bartoszp1992/pulsar/simulation/StepUpDown.asc

C1: cap; 100µ; Rser=10m
C2: cap; 100µ; Rser=100m
C3: cap; 10µ; Rser=10m
D1: diode
D2: diode
L1: ind; 33µ; Rser=36m
M1: pmos; FDS4559_P
M2: nmos; IRFZ44N
R1: res; 1k
R2: res; 1k
R3: res; 1
V1: voltage; 5
V2: voltage; PULSE(0 10 0 0 0 1900ns 2000ns)
V3: voltage; PULSE(0 10 0 0 0 1500ns 2000ns)
Named nets: INPUT, HSW, 0, LSW, OUTPUT
.tran 0 5m 0 10m startup
