bartoszp1992/pulsar/simulation/SEPIC.asc

C1: cap; 10µ
C2: cap; 100µ
D1: diode
L1: ind; 33µ
L2: ind; 33µ
M1: nmos; IRFZ44BART
R1: res; 50
V1: voltage; PULSE(0 5 0 0 0 15us 20us)
V2: voltage; 10
Named nets: 0, IN, OUT, GATE
.tran 0 1ms 0 10ms
.model IRFZ44BART VDMOS(Rg=1.94 Vto=4 Rd=5.0m Rs=0.0m Rb=6.8m Kp=19 Cgdmax=2.0n Cgdmin=0.08n Cgs=1.4n Cjo=0.9n Is=1.5p tt=63n ksubthres=.1 mfg=International_Rectifier Vds=55 Ron=13.9m Qg=63n)
