bartoszp1992/pulsar/pulsarPCB/pulsarPCB.kicad_pcb

## KiCad design pulsarPCB/pulsarPCB.kicad_pcb (2024-03-15)

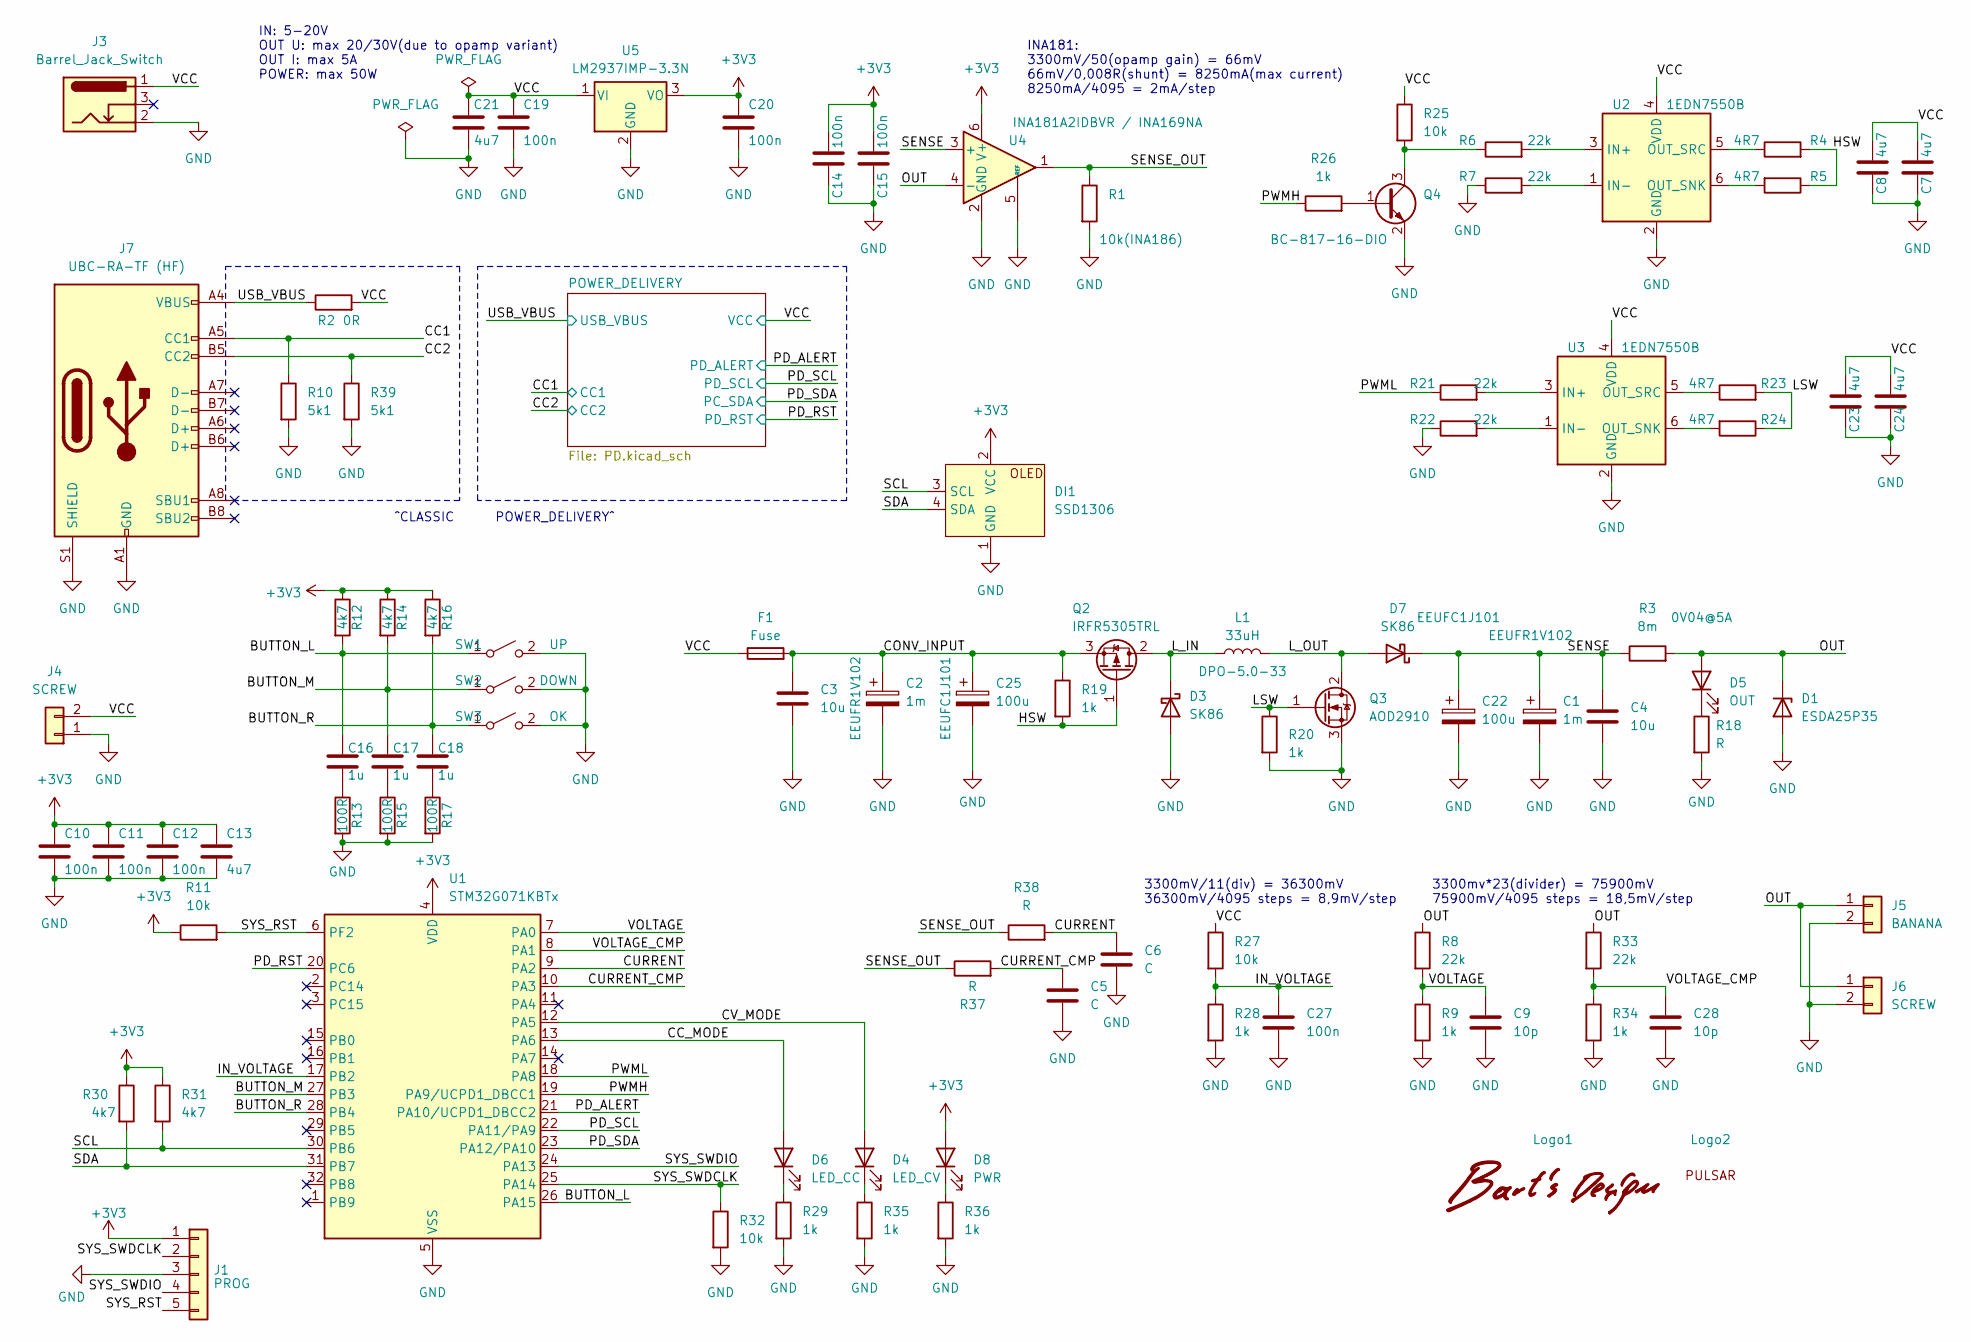
[picture p1: schematic pulsarPCB.kicad_sch]

Parts:
C1, C2: 1m; CP_Radial_D12.5mm_P5.00mm
C3, C4: 10u; C_1206_3216Metric
C5, C6: C; C_0603_1608Metric
C7, C8, C13, C21, C23, C24: 4u7; C_1206_3216Metric
C9, C28: 10p; C_0603_1608Metric
C10, C11, C12, C14, C15, C19, C20, C27: 100n; C_0603_1608Metric
C16, C17, C18: 1u; C_0603_1608Metric
C22, C25: 100u; CP_Radial_D10.0mm_P5.00mm
D1: ESDA25P35; D_0603_1608Metric
D3, D7: SK86; D_SMC
D4: LED_CV; LED_0603_1608Metric
D5: OUT; LED_0603_1608Metric
D6: LED_CC; LED_0603_1608Metric
D8: PWR; LED_0603_1608Metric
DI1: SSD1306
F1: Fuse; Fuse_1206_3216Metric
J1: PROG; PinHeader_1x05_P2.54mm_Vertical
J3: Barrel_Jack_Switch; BarrelJack_Horizontal
J4, J6: SCREW; DEGSON DG301-5.0-2.0P
J5: BANANA; BANANA 4mm
J7: UBC-RA-TF (HF)
L1: 33uH; DPO-5.0-33
Logo1: Bart's Design
Logo2: PULSAR
Q2: IRFR5305TRL; TO-252-2
Q3: AOD2910; TO-252-2
Q4: BC-817-16-DIO; SOT-23
R1: 10k(INA186); R_0603_1608Metric
R2: 0R; D_0603_1608Metric
R3: 8m; R_2512_6332Metric
R4, R5, R23, R24: 4R7; R_1206_3216Metric
R6, R7, R8, R21, R22, R33: 22k; R_0603_1608Metric
R9, R19, R20, R26, R28, R29, R34, R35, R36: 1k; R_0603_1608Metric
R10, R39: 5k1; R_0603_1608Metric
R11, R25, R27, R32: 10k; R_0603_1608Metric
R12, R14, R16, R30, R31: 4k7; R_0603_1608Metric
R13, R15, R17: 100R; R_0805_2012Metric
R18, R37, R38: R; R_0603_1608Metric
SW1: UP; SW_PUSH_6mm
SW2: DOWN; SW_PUSH_6mm
SW3: OK; SW_PUSH_6mm
U1: STM32G071KBTx; LQFP-32_7x7mm_P0.8mm
U2, U3: 1EDN7550B; SOT-23-6
U4: INA181A2IDBVR / INA169NA; SOT-23-6
U5: LM2937IMP-3.3N; SOT-223-3_TabPin2

Connections:
+3V3: C10.1, C11.1, C12.1, C13.1, C14.2, C15.2, C20.1, D8.2 (A), DI1.2 (VCC), J1.1, R11.1, R12.1, R14.1, R16.1, R30.1, R31.1, U1.4 (VDD), U4.6 (V+), U5.3 (VO); also elsewhere on the board
/BUTTON_L: C16.1, R12.2, SW1.1 (A), U1.26 (PA15)
/BUTTON_M: C17.1, R14.2, SW2.1 (A), U1.27 (PB3)
/BUTTON_R: C18.1, R16.2, SW3.1 (A), U1.28 (PB4)
/CC1: J7.A5 (CC1), R10.1; also elsewhere on the board
/CC2: J7.B5 (CC2), R39.1; also elsewhere on the board
/CC_MODE: D6.2 (A), U1.13 (PA6)
/CONV_INPUT: C2.1, C3.1, C25.1, F1.2, Q2.3 (S), R19.1
/CURRENT: C6.2, R38.2, U1.9 (PA2)
/CURRENT_CMP: C5.2, R37.2, U1.10 (PA3)
/CV_MODE: D4.2 (A), U1.12 (PA5)
/HSW: Q2.1 (G), R4.2, R5.1, R19.2
/IN_VOLTAGE: C27.1, R27.2, R28.1, U1.17 (PB2)
/LSW: Q3.1 (G), R20.1, R23.2, R24.1
/L_IN: D3.1 (K), L1.1, Q2.2 (D)
/L_OUT: D7.2 (A), L1.2, Q3.2 (D)
/OUT: D1.1 (K), D5.2 (A), J5.1, J6.1, R3.2, R8.1, R33.1, U4.4 (-)
/PD_ALERT: U1.21 (PA10/UCPD1_DBCC2); also elsewhere on the board
/PD_RST: U1.20 (PC6); also elsewhere on the board
/PD_SCL: U1.22 (PA11/PA9); also elsewhere on the board
/PD_SDA: U1.23 (PA12/PA10); also elsewhere on the board
/PWMH: R26.1, U1.19 (PA9/UCPD1_DBCC1)
/PWML: R21.1, U1.18 (PA8)
/SCL: DI1.3 (SCL), R31.2, U1.30 (PB6)
/SDA: DI1.4 (SDA), R30.2, U1.31 (PB7)
/SENSE: C1.1, C4.1, C22.1, D7.1 (K), R3.1, U4.3 (+)
/SENSE_OUT: R1.1, R37.1, R38.1, U4.1
/SYS_RST: J1.5, R11.2, U1.6 (PF2)
/SYS_SWDCLK: J1.2, R32.1, U1.25 (PA14)
/SYS_SWDIO: J1.4, U1.24 (PA13)
/USB_VBUS: J7.A4 (VBUS), J7.A9 (VBUS), J7.B4 (VBUS), J7.B9 (VBUS), R2.1; also elsewhere on the board
/VCC: C7.2, C8.2, C19.1, C21.2, C23.2, C24.2, F1.1, J3.1, J4.2, R2.2, R25.1, R27.1, U2.4 (VDD), U3.4 (VDD), U5.1 (VI); also elsewhere on the board
/VOLTAGE: C9.1, R8.2, R9.1, U1.7 (PA0)
/VOLTAGE_CMP: C28.1, R33.2, R34.1, U1.8 (PA1)
GND: C1.2, C2.2, C3.2, C4.2, C5.1, C6.1, C7.1, C8.1, C9.2, C10.2, C11.2, C12.2, C13.2, C14.1, C15.1, C19.2, C20.2, C21.1, C22.2, C23.1, C24.1, C25.2, C27.2, C28.2, D1.2 (A), D3.2 (A), DI1.1 (GND), J1.3, J3.2, J4.1, J5.2, J6.2, J7.A1 (GND), J7.A12 (GND), J7.B1 (GND), J7.B12 (GND), J7.S1 (SHIELD), Q3.3 (S), Q4.2 (E), R1.2, R7.1, R9.2, R10.2, R13.2, R15.2, R17.2, R18.2, R20.2, R22.1, R28.2, R29.2, R32.2, R34.2, R35.2, R36.2, R39.2, SW1.2 (B), SW2.2 (B), SW3.2 (B), U1.5 (VSS), U2.2 (GND), U3.2 (GND), U4.2 (GND), U4.5 (REF), U5.2 (GND); also elsewhere on the board
unnamed: C16.2, R13.1
unnamed: C17.2, R15.1
unnamed: C18.2, R17.1
unnamed: D4.1 (K), R35.1
unnamed: D5.1 (K), R18.1
unnamed: D6.1 (K), R29.1
unnamed: D8.1 (K), R36.1
unnamed: Q4.1 (B), R26.2
unnamed: Q4.3 (C), R6.1, R25.2
unnamed: R6.2, U2.3 (IN+)
unnamed: R7.2, U2.1 (IN-)
unnamed: R5.2, U2.6 (OUT_SNK)
unnamed: R4.1, U2.5 (OUT_SRC)
unnamed: R21.2, U3.3 (IN+)
unnamed: R22.2, U3.1 (IN-)
unnamed: R24.2, U3.6 (OUT_SNK)
unnamed: R23.1, U3.5 (OUT_SRC)

Notes on the sheet:
IN: 5-20V OUT U: max 20/30V(due to opamp variant) OUT I: max 5A POWER: max 50W
3300mV/11(div) = 36300mV 36300mV/4095 steps = 8,9mV/step
3300mv*23(divider) = 75900mV 75900mV/4095 steps = 18,5mV/step
^CLASSIC POWER_DELIVERY^
INA181: 3300mV/50(opamp gain) = 66mV 66mV/0,008R(shunt) = 8250mA(max current) 8250mA/4095 = 2mA/step

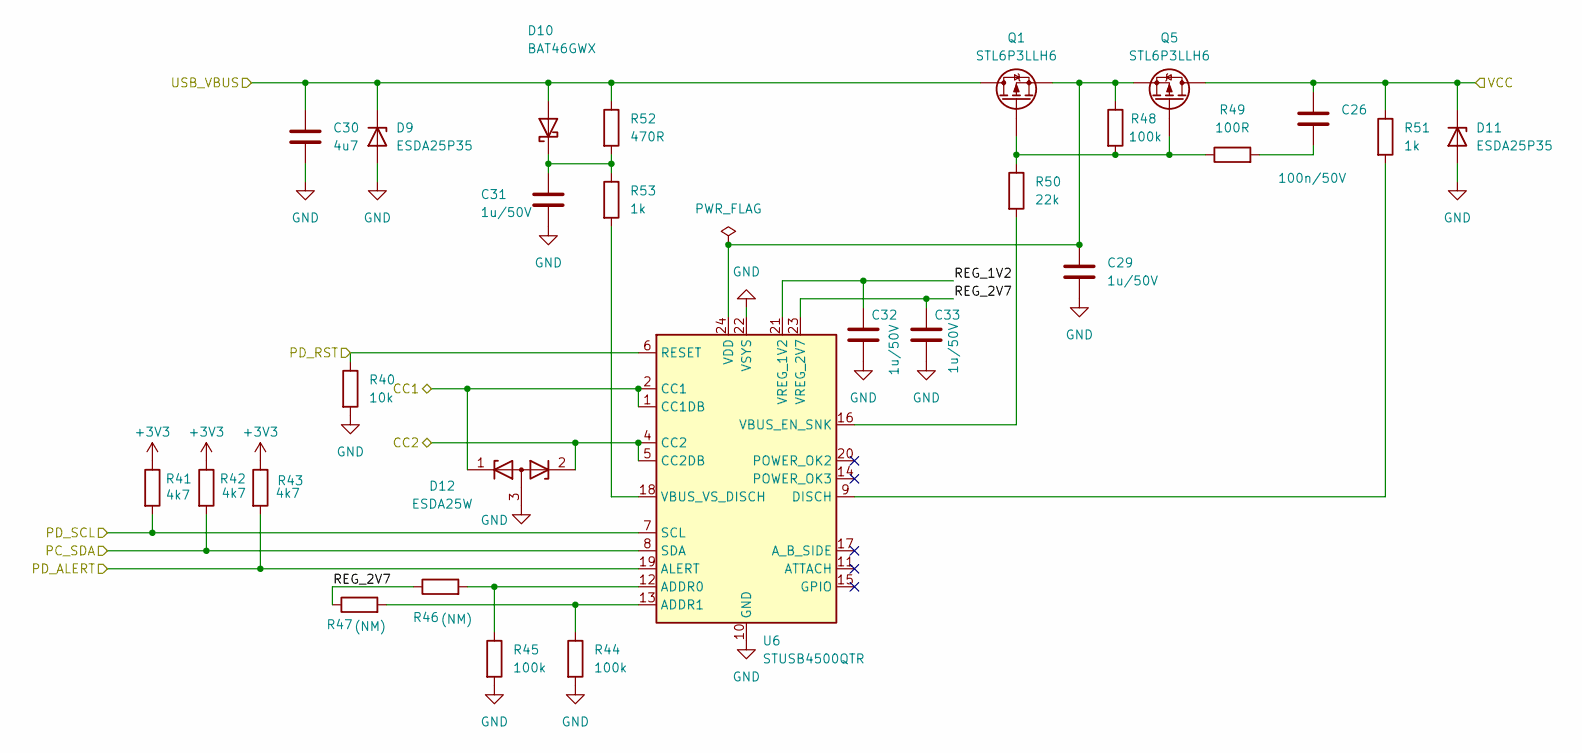
[picture p2: schematic PD.kicad_sch]

Parts:
C26: 100n/50V; C_0603_1608Metric
C29, C31, C32, C33: 1u/50V; C_0603_1608Metric
C30: 4u7; C_1206_3216Metric
D9, D11: ESDA25P35; D_0603_1608Metric
D10: BAT46GWX; D_SOD-123
D12: ESDA25W; SOT-323L
Q1, Q5: STL6P3LLH6; PowerFLAT 3.3x3.3
R40: 10k; R_0603_1608Metric
R41, R42, R43: 4k7; R_0603_1608Metric
R44, R45, R48: 100k; R_0603_1608Metric
R46, R47: (NM); R_0603_1608Metric
R49: 100R; R_0805_2012Metric
R50: 22k; R_0603_1608Metric
R51, R53: 1k; R_0603_1608Metric
R52: 470R; R_0603_1608Metric
U6: STUSB4500QTR; QFN-24-1EP_4x4mm_P0.5mm_EP2.7x2.7mm

Connections:
+3V3: R41.1, R42.1, R43.1; also elsewhere on the board
/CC1: D12.1 (K), U6.1 (CC1DB), U6.2 (CC1); also elsewhere on the board
/CC2: D12.2 (K), U6.4 (CC2), U6.5 (CC2DB); also elsewhere on the board
/PD_ALERT: R43.2, U6.19 (ALERT); also elsewhere on the board
/PD_RST: R40.1, U6.6 (RESET); also elsewhere on the board
/PD_SCL: R41.2, U6.7 (SCL); also elsewhere on the board
/PD_SDA: R42.2, U6.8 (SDA); also elsewhere on the board
/POWER_DELIVERY/REG_1V2: C32.1, U6.21 (VREG_1V2)
/POWER_DELIVERY/REG_2V7: C33.1, R46.1, R47.1, U6.23 (VREG_2V7)
/USB_VBUS: C30.1, D9.1 (K), D10.2 (A), Q1.5 (D), Q1.6 (D), Q1.7 (D), Q1.8 (D), R52.1; also elsewhere on the board
/VCC: C26.1, D11.1 (K), Q5.5 (D), Q5.6 (D), Q5.7 (D), Q5.8 (D), R51.1; also elsewhere on the board
GND: C29.2, C30.2, C31.2, C32.2, C33.2, D9.2 (A), D11.2 (A), D12.3 (A), R40.2, R44.2, R45.2, U6.10 (GND), U6.22 (VSYS), U6.25 (GND); also elsewhere on the board
unnamed: C26.2, R49.2
unnamed: C31.1, D10.1 (K), R52.2, R53.1
unnamed: Q1.4 (G), Q5.4 (G), R48.2, R49.1, R50.1
unnamed: R45.1, R46.2, U6.12 (ADDR0)
unnamed: R44.1, R47.2, U6.13 (ADDR1)
unnamed: R51.2, U6.9 (DISCH)
unnamed: R50.2, U6.16 (VBUS_EN_SNK)
unnamed: R53.2, U6.18 (VBUS_VS_DISCH)
unnamed: C29.1, Q1.1 (S), Q1.2 (S), Q1.3 (S), Q5.1 (S), Q5.2 (S), Q5.3 (S), R48.1, U6.24 (VDD)

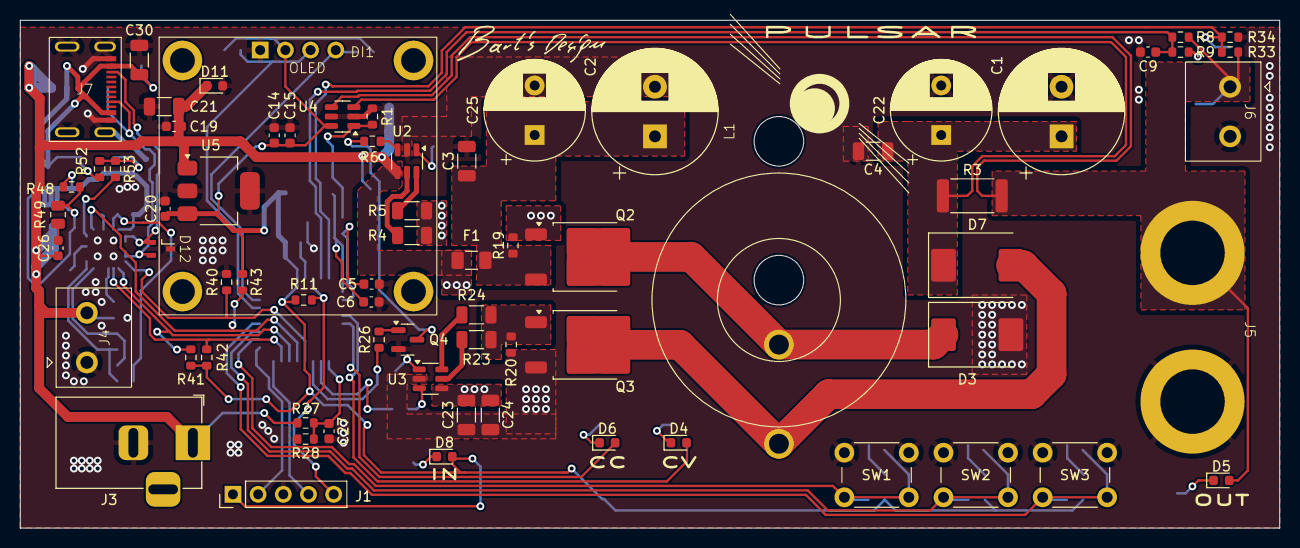
[picture p3: board pulsarPCB.kicad_pcb from above]

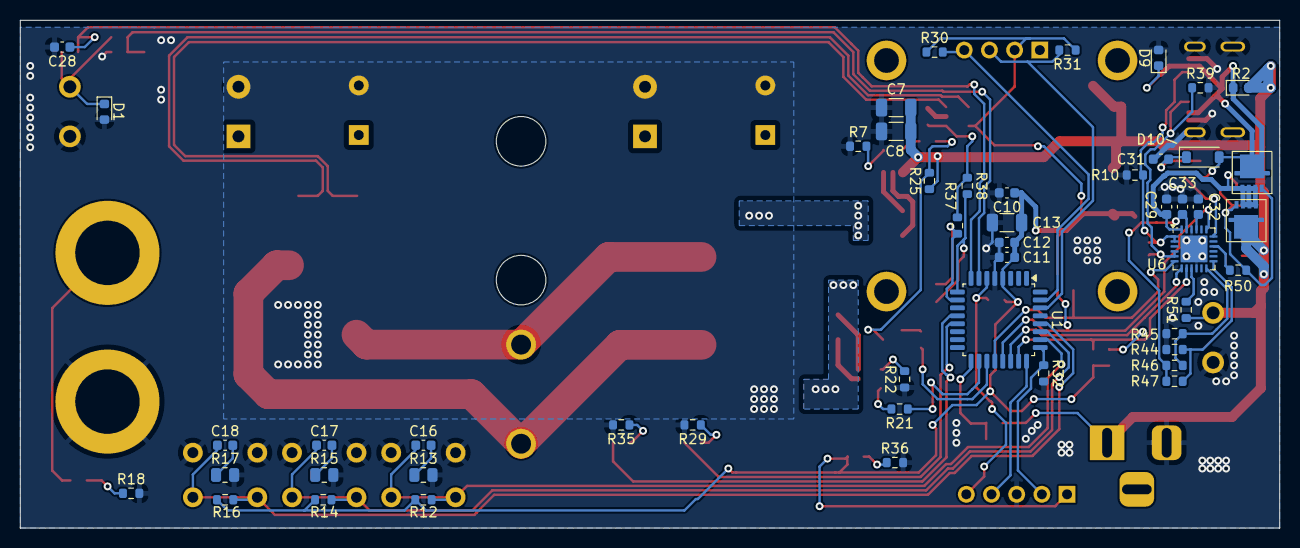
[picture p4: board pulsarPCB.kicad_pcb from below]

Board: 2 copper layers, 127.0 x 51.2 mm, 122 parts (49 on the bottom side), 63 nets.
