bartoszp1992/pulsar/pulsar-firmware/pulsar-firmware.ioc

Mcu.UserName=STM32G071KBTx
PA0.GPIO_Label=VOLTAGE
PA0.Signal=ADC1_IN0
PA1.GPIO_Label=VOLTAGE_CMP
PA1.Signal=COMP1_INP
PA10.GPIO_Label=PD_ALERT
PA10.Signal=GPIO_Input
PA13.Signal=SYS_SWDIO
PA14-BOOT0.Signal=SYS_SWCLK
PA15.GPIO_Label=BUTTON_RIGHT
PA15.Signal=GPIO_Input
PA2.GPIO_Label=CURRENT
PA2.Signal=ADC1_IN2
PA3.GPIO_Label=CURRENT_COMP
PA3.Signal=COMP2_INP
PA5.GPIO_Label=LED_CV
PA5.Signal=GPIO_Output
PA6.GPIO_Label=LED_CC
PA6.Signal=GPIO_Output
PA8.GPIO_Label=LOW_SW_CH1
PA8.Signal=S_TIM1_CH1
PA9.GPIO_Label=HIGH_SW_CH2
PA9.Signal=S_TIM1_CH2
PB2.GPIO_Label=INPUT_VOLTAGE
PB2.Signal=ADC1_IN10
PB3.GPIO_Label=BUTTON_MID
PB3.Signal=GPIO_Input
PB4.GPIO_Label=BUTTON_LEFT
PB4.Signal=GPIO_Input
PB6.Signal=I2C1_SCL
PB7.Signal=I2C1_SDA
PC6.GPIO_Label=PD_RST
PC6.Signal=GPIO_Output
