bartoszp1992/pulsar/stm32-ssd1306-master/examples/oled-tester/firmware/i2c/Inc/main.h

#define B1_Pin GPIO_PIN_13
#define B1_GPIO_Port GPIOC
#define OLED_CS_Pin GPIO_PIN_0
#define OLED_CS_GPIO_Port GPIOC
#define OLED_DC_Pin GPIO_PIN_1
#define OLED_DC_GPIO_Port GPIOC
#define Bus_Btn_Pin GPIO_PIN_0
#define Bus_Btn_GPIO_Port GPIOA
#define SPI_Led_Pin GPIO_PIN_1
#define SPI_Led_GPIO_Port GPIOA
#define USART_TX_Pin GPIO_PIN_2
#define USART_TX_GPIO_Port GPIOA
#define USART_RX_Pin GPIO_PIN_3
#define USART_RX_GPIO_Port GPIOA
#define I2C_Led_Pin GPIO_PIN_4
#define I2C_Led_GPIO_Port GPIOA
#define OLED_Res_Pin GPIO_PIN_0
#define OLED_Res_GPIO_Port GPIOB
#define TMS_Pin GPIO_PIN_13
#define TMS_GPIO_Port GPIOA
#define TCK_Pin GPIO_PIN_14
#define TCK_GPIO_Port GPIOA
#define SWO_Pin GPIO_PIN_3
#define SWO_GPIO_Port GPIOB
