bartoszp1992/pulsar/(commit log)

2024-02-08 change topology
    [pulsarPCB.kicad_pcb, pulsarPCB.kicad_sch]
2024-03-15 PCB v1
    [PD.kicad_sch, oled-tester.kicad_pcb, oled-tester.sch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]
