bartoszp1992/pulsar/(notices)

Notices in the files:
stm32-ssd1306-master/examples/oled-tester/firmware/spi/Inc/main.h:
COPYRIGHT(c) 2018 STMicroelectronics
(C) COPYRIGHT STMicroelectronics *****END OF FILE
pulsar-firmware/Src/adc.c:
Copyright (c) 2024 STMicroelectronics.
All rights reserved.
This software is licensed under terms that can be found in the LICENSE file
